MetropoliaMotorsport/AMS-MASTER/README.md

Changes for next year:
Labels on other side
Remove unused connectors
Add connection for temperature measurement of DCDC
