MetropoliaMotorsport/AMS-MASTER/AMS Master BOM.xlsx

References | Value | Footprint | Quantity | €/pc | Total price
C5, C19, C20, C21, C23, C24, C25, C26, C27, C28, C29, C30, C31, C32, C33, C34, C35, C37, C39, C40, C41, C42 | 100nF | C_0805_2012Metric_Pad1.18x1.45mm_HandSolder | 22 | 0.04 € | 0.88 €
C1, C2, C36 | 30pF | C_0805_2012Metric_Pad1.18x1.45mm_HandSolder | 3 | 0.31 € | 0.93 €
C3, C4 | 100nF | C_0603_1608Metric_Pad1.08x0.95mm_HandSolder | 2 | 0.04 € | 0.08 €
C9, C13 | 2.2uF | C_0805_2012Metric_Pad1.18x1.45mm_HandSolder | 2 | 0.19 € | 0.38 €
C10, C14 | 0.22uF | C_0805_2012Metric_Pad1.18x1.45mm_HandSolder | 2 | 0.10 € | 0.20 €
C11, C15 | 22pF | C_0805_2012Metric_Pad1.18x1.45mm_HandSolder | 2 | 0.15 € | 0.30 €
C12, C16 | 22uF | C_0805_2012Metric_Pad1.18x1.45mm_HandSolder | 2 | 0.22 € | 0.44 €
C6 | 4.7uF | C_0603_1608Metric_Pad1.08x0.95mm_HandSolder | 1 | 0.15 € | 0.15 €
C7 | 10nF | C_0603_1608Metric_Pad1.08x0.95mm_HandSolder | 1 | 0.23 € | 0.23 €
C8 | 1uF | C_0603_1608Metric_Pad1.08x0.95mm_HandSolder | 1 | 0.15 € | 0.15 €
C17 | 10nF | C_0805_2012Metric_Pad1.18x1.45mm_HandSolder | 1 | 0.46 € | 0.46 €
C18 | 10uF | C_0805_2012Metric_Pad1.18x1.45mm_HandSolder | 1 | 0.31 € | 0.31 €
C38 | 4.7nF | C_0805_2012Metric_Pad1.18x1.45mm_HandSolder | 1 | 0.90 € | 0.90 €
R2, R13, R14, R15, R40, R41, R42, R43 | 10k | R_0805_2012Metric_Pad1.20x1.40mm_HandSolder | 8 | 0.02 € | 0.16 €
R16, R17, R18, R19, R20, R21 | 33k | R_0805_2012Metric_Pad1.20x1.40mm_HandSolder | 6 | 0.01 € | 0.06 €
R23, R31, R45, R47 | 11k | R_0805_2012Metric_Pad1.20x1.40mm_HandSolder | 4 | 0.03 € | 0.12 €
R4, R12, R44 | 470 | R_0805_2012Metric_Pad1.20x1.40mm_HandSolder | 3 | 0.03 € | 0.09 €
R8, R38, R39 | 330 | R_0805_2012Metric_Pad1.20x1.40mm_HandSolder | 3 | 0.03 € | 0.09 €
R22, R24, R46 | 6k | R_0805_2012Metric_Pad1.20x1.40mm_HandSolder | 3 | 0.02 € | 0.06 €
R25, R26, R28 | 22k | R_0805_2012Metric_Pad1.20x1.40mm_HandSolder | 3 | 0.03 € | 0.09 €
R1, R3 | 331 | R_0603_1608Metric_Pad0.98x0.95mm_HandSolder | 2 | 0.11 € | 0.22 €
R6, R10 | 1M | R_0805_2012Metric_Pad1.20x1.40mm_HandSolder | 2 | 0.03 € | 0.06 €
R34, R35 | 1k | R_0805_2012Metric_Pad1.20x1.40mm_HandSolder | 2 | 0.28 € | 0.56 €
R36, R37 | 60 | R_0603_1608Metric_Pad0.98x0.95mm_HandSolder | 2 | 0.26 € | 0.52 €
R5 | 220k | R_0805_2012Metric_Pad1.20x1.40mm_HandSolder | 1 | 0.03 € | 0.03 €
R7 | 576k | R_0805_2012Metric_Pad1.20x1.40mm_HandSolder | 1 | 0.03 € | 0.03 €
R9 | 226k | R_0805_2012Metric_Pad1.20x1.40mm_HandSolder | 1 | 0.03 € | 0.03 €
R11 | 316k | R_0805_2012Metric_Pad1.20x1.40mm_HandSolder | 1 | 0.03 € | 0.03 €
R27 | 2.2k | R_0805_2012Metric_Pad1.20x1.40mm_HandSolder | 1 | 0.28 € | 0.28 €
R29 | 15k | R_0805_2012Metric_Pad1.20x1.40mm_HandSolder | 1 | 0.03 € | 0.03 €
R30 | 9.1k | R_0805_2012Metric_Pad1.20x1.40mm_HandSolder | 1 | 0.34 € | 0.34 €
R32 | 13k | R_0805_2012Metric_Pad1.20x1.40mm_HandSolder | 1 | 0.03 € | 0.03 €
R33 | 1.21k | R_0805_2012Metric_Pad1.20x1.40mm_HandSolder | 1 | 0.28 € | 0.28 €
L1, L2 | 22uH | SLF7045T | 2 | 1.04 € | 2.08 €
D1, D2, D3, D4, D11 | KT-0603R | LED_0603_1608Metric_Pad1.05x0.95mm_HandSolder | 5 | 0.13 € | 0.65 €
D7, D8, D9, D12 | 5.1V | SOD-323 | 4 | 0.08 € | 0.32 €
D5 | STPS5L25B-TR | TO-252-2_TabPin1 | 1 | 1.63 € | 1.63 €
D6 | SMBJ26A | DO-214AA | 1 | 0.43 € | 0.43 €
U6, U7, U8, U9, U10 | LM293 | SOIC-8 | 5 | 0.33 € | 1.65 €
U2, U3 | LT3970 | LT3970 | 2 | 5.72 € | 11.44 €
U4, U5 | OR-gate | SOT-753 | 2 | 0.19 € | 0.38 €
U1 | STM32G431KBTx | LQFP-32_7x7mm_P0.8mm | 1 | 7.22 € | 7.22 €
U11 | LTC6820 | ltc6820 | 1 | 6.54 € | 6.54 €
U12 | SN65HVD230 | SOIC-8_3.9x4.9mm_P1.27mm | 1 | 3.28 € | 3.28 €
U13 | ESDCAN24-2BLY | SOT-23-3 | 1 | 0.42 € | 0.42 €
Y1 | 16MHz Crystal | Crystal_SMD_HC49-SD | 1 | 0.33 € | 0.33 €
F1 | DLW5BTM501TQ2L | Filter_DLW5BTM501TQ2L | 1 | 1.16 € | 1.16 €
SW1 | CS11024.3F160 | SW_Push_1P1T_NO_6x6mm_H9.5mm | 1 | 0.25 € | 0.25 €
Q1, Q2 | AO4612 | SOIC-8_3.9x4.9mm_P1.27mm | 2 | 0.73 € | 1.46 €
Q3, Q4 | BSS123 | SOT-323_SC-70_Handsoldering | 2 | 0.27 € | 0.54 €
T1-1 | SM91501AL-E | SM91501AL-E | 1 | 5.08 € | 5.08 €
J2, J3, J4, J5, J7, J8 | Molex 26-01-3127 | Molex_Mini-Fit_Jr_5569-02A2_2x01_P4.20mm_Horizontal | 6 | 0.68 € | 4.08 €
J6, J9 | Molex 39303036 | Molex_Mini-Fit_Jr_5569-03A4_1x03_P4.20mm_Horizontal | 2 | 0.74 € | 1.48 €
J1 | Molex 39301040 | Molex_Mini-Fit_Jr_5569-04A2_2x02_P4.20mm_Horizontal | 1 | 0.58 € | 0.58 €
PCB |  |  | 1 | 27.11 € | 27.11 €
 |  |  |  |  | 86.63 €
