MetropoliaMotorsport/AMS-MASTER/AMS Master V8.kicad_pcb

## KiCad design AMS Master V8.kicad_pcb (2024-07-11)

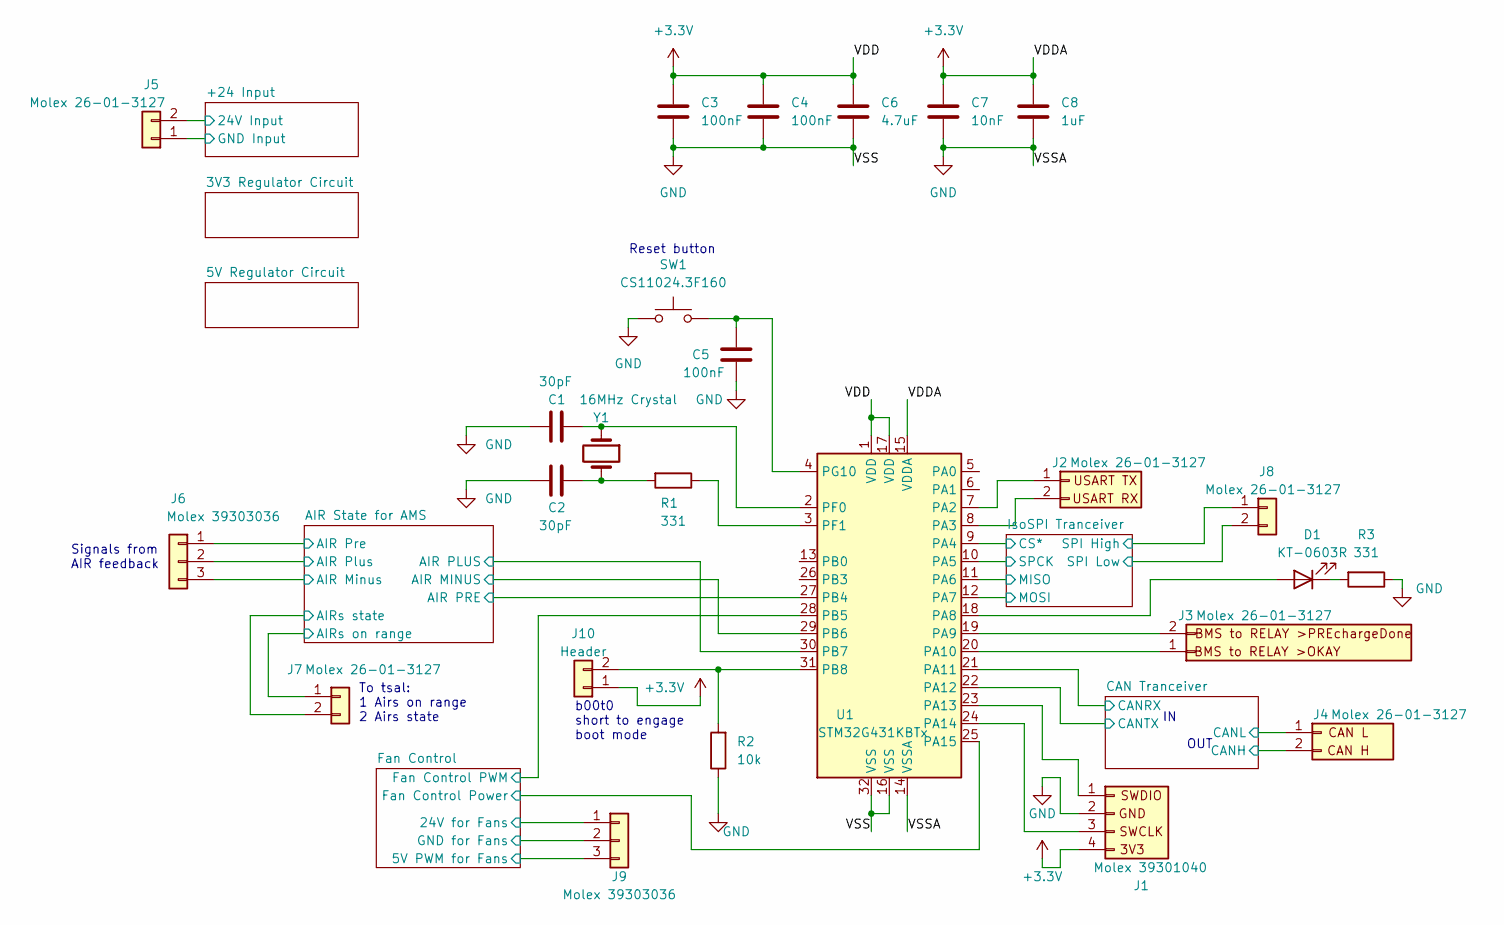
[picture p1: schematic AMS Master V8.kicad_sch, AMS Master by Jakub Sułek]

Parts:
C1, C2: 30pF; C_0805_2012Metric_Pad1.18x1.45mm_HandSolder
C3, C4: 100nF; C_0603_1608Metric_Pad1.08x0.95mm_HandSolder
C5: 100nF; C_0805_2012Metric_Pad1.18x1.45mm_HandSolder
C6: 4.7uF; C_0603_1608Metric_Pad1.08x0.95mm_HandSolder
C7: 10nF; C_0603_1608Metric_Pad1.08x0.95mm_HandSolder
C8: 1uF; C_0603_1608Metric_Pad1.08x0.95mm_HandSolder
D1: KT-0603R; LED_0603_1608Metric_Pad1.05x0.95mm_HandSolder
J1: Molex 39301040; Molex_Mini-Fit_Jr_5569-04A2_2x02_P4.20mm_Horizontal
J2, J3, J4, J5, J7, J8: Molex 26-01-3127; Molex_Mini-Fit_Jr_5569-02A2_2x01_P4.20mm_Horizontal
J6, J9: Molex 39303036; Molex_Mini-Fit_Jr_5569-03A4_1x03_P4.20mm_Horizontal
J10: Header; PinHeader_1x02_P2.54mm_Vertical
R1, R3: 331; R_0603_1608Metric_Pad0.98x0.95mm_HandSolder
R2: 10k; R_0805_2012Metric_Pad1.20x1.40mm_HandSolder
SW1: CS11024.3F160; SW_Push_1P1T_NO_6x6mm_H9.5mm
U1: STM32G431KBTx; LQFP-32_7x7mm_P0.8mm
Y1: 16MHz Crystal; Crystal_SMD_HC49-SD

Connections:
+VDC: J5.2; also elsewhere on the board
/AIR State for AMS/AIR MINUS: U1.29 (PB6); also elsewhere on the board
/AIR State for AMS/AIR Minus: J6.3; also elsewhere on the board
/AIR State for AMS/AIR PLUS: U1.30 (PB7); also elsewhere on the board
/AIR State for AMS/AIR PRE: U1.27 (PB4); also elsewhere on the board
/AIR State for AMS/AIR Plus: J6.2; also elsewhere on the board
/AIR State for AMS/AIR Pre: J6.1; also elsewhere on the board
/AIR State for AMS/AIRs on range: J7.1; also elsewhere on the board
/AIR State for AMS/AIRs state: J7.2; also elsewhere on the board
/CAN Tranceiver/CANH: J4.2; also elsewhere on the board
/CAN Tranceiver/CANL: J4.1; also elsewhere on the board
/CAN Tranceiver/CANRX: U1.21 (PA11); also elsewhere on the board
/CAN Tranceiver/CANTX: U1.22 (PA12); also elsewhere on the board
/Fan Control/5V PWM for Fans: J9.3, U1.28 (PB5)
/Fan Control/24V for Fans: J9.1; also elsewhere on the board
/Fan Control/Fan Control Power: U1.25 (PA15); also elsewhere on the board
/IsoSPI Tranceiver/CS*: U1.9 (PA4); also elsewhere on the board
/IsoSPI Tranceiver/MISO: U1.11 (PA6); also elsewhere on the board
/IsoSPI Tranceiver/MOSI: U1.12 (PA7); also elsewhere on the board
/IsoSPI Tranceiver/SPCK: U1.10 (PA5); also elsewhere on the board
/IsoSPI Tranceiver/SPI High: J8.1; also elsewhere on the board
/IsoSPI Tranceiver/SPI Low: J8.2; also elsewhere on the board
unnamed: C2.1, R1.2, Y1.2
unnamed: D1.2 (A), U1.18 (PA8)
unnamed: D1.1 (K), R3.2
unnamed: J1.1, U1.23 (PA13)
unnamed: J1.3, U1.24 (PA14)
unnamed: J2.1, U1.7 (PA2)
unnamed: J2.2, U1.8 (PA3)
unnamed: J3.1, U1.20 (PA10)
unnamed: J3.2, U1.19 (PA9)
unnamed: J10.2, R2.2, U1.31 (PB8)
unnamed: C1.1, U1.2 (PF0), Y1.1
unnamed: R1.1, U1.3 (PF1)
unnamed: C5.1, SW1.2, U1.4 (PG10)

Notes on the sheet:
OUT
Reset button
To tsal: 1 Airs on range 2 Airs state
b00t0 short to engage boot mode
Signals from AIR feedback

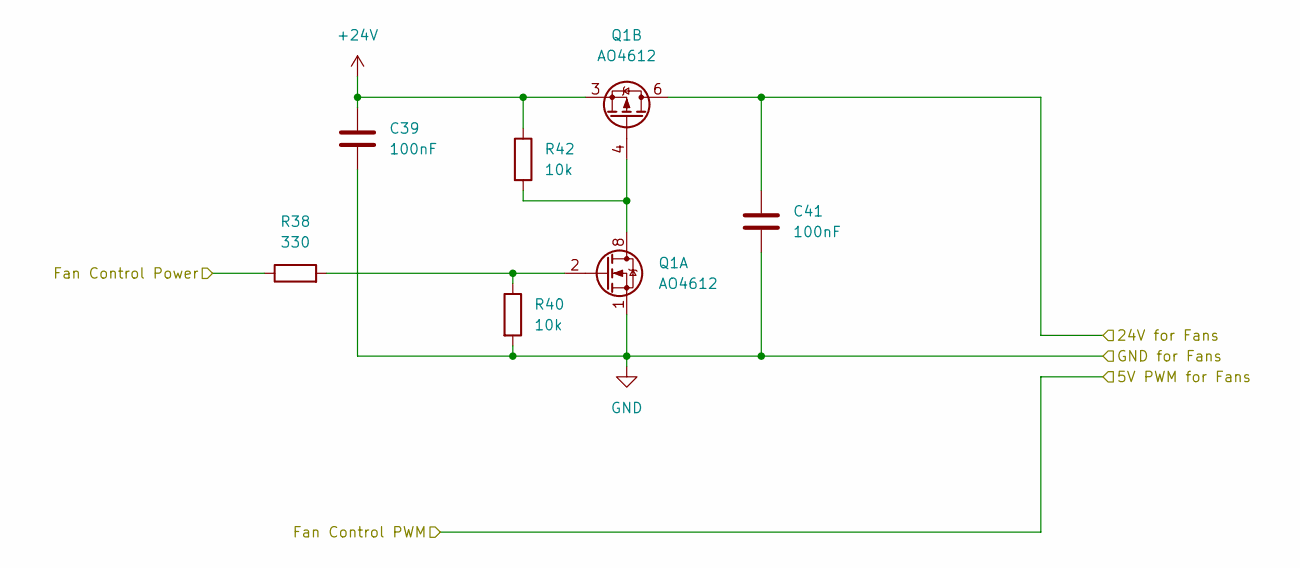
[picture p2: schematic Fan Control.kicad_sch, AMS Master by Jakub Sułek]

Parts:
C39, C41: 100nF; C_0805_2012Metric_Pad1.18x1.45mm_HandSolder
Q1: AO4612; SOIC-8_3.9x4.9mm_P1.27mm
R38: 330; R_0805_2012Metric_Pad1.20x1.40mm_HandSolder
R40, R42: 10k; R_0805_2012Metric_Pad1.20x1.40mm_HandSolder

Connections:
+24V: C39.1, Q1.3 (1), R42.1; also elsewhere on the board
/Fan Control/24V for Fans: C41.1, Q1.5 (D), Q1.6 (D); also elsewhere on the board
/Fan Control/Fan Control Power: R38.1; also elsewhere on the board
unnamed: Q1.2 (G), R38.2, R40.1
unnamed: Q1.4 (G), Q1.7 (D), Q1.8 (D), R42.2

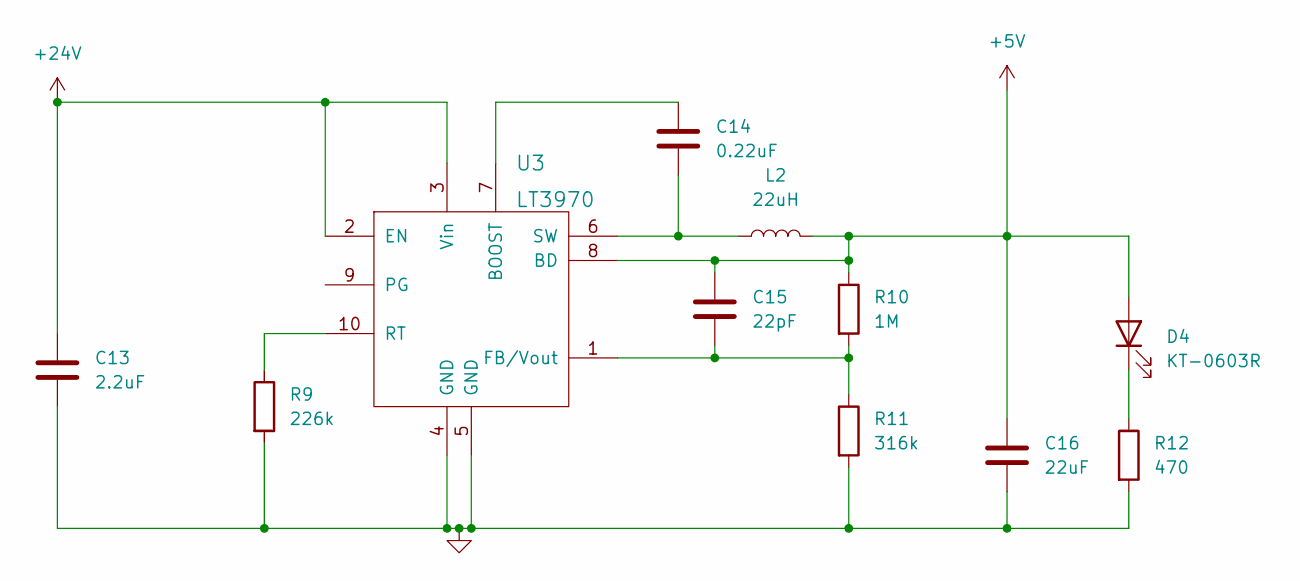
[picture p3: schematic 5V Regulator Circuit.kicad_sch, AMS Master by Jakub Sułek]

Parts:
C13: 2.2uF; C_0805_2012Metric_Pad1.18x1.45mm_HandSolder
C14: 0.22uF; C_0805_2012Metric_Pad1.18x1.45mm_HandSolder
C15: 22pF; C_0805_2012Metric_Pad1.18x1.45mm_HandSolder
C16: 22uF; C_0805_2012Metric_Pad1.18x1.45mm_HandSolder
D4: KT-0603R; LED_0603_1608Metric_Pad1.05x0.95mm_HandSolder
L2: 22uH; SLF7045T
R9: 226k; R_0805_2012Metric_Pad1.20x1.40mm_HandSolder
R10: 1M; R_0805_2012Metric_Pad1.20x1.40mm_HandSolder
R11: 316k; R_0805_2012Metric_Pad1.20x1.40mm_HandSolder
R12: 470; R_0805_2012Metric_Pad1.20x1.40mm_HandSolder
U3: LT3970

Connections:
+5V: C15.1, C16.1, D4.2 (A), L2.2, R10.1, U3.8 (BD); also elsewhere on the board
+24V: C13.1, U3.2 (EN), U3.3 (Vin); also elsewhere on the board
unnamed: D4.1 (K), R12.1
unnamed: C14.1, U3.7 (BOOST)
unnamed: C15.2, R10.2, R11.1, U3.1 (FB/Vout)
unnamed: R9.1, U3.10 (RT)
unnamed: C14.2, L2.1, U3.6 (SW)

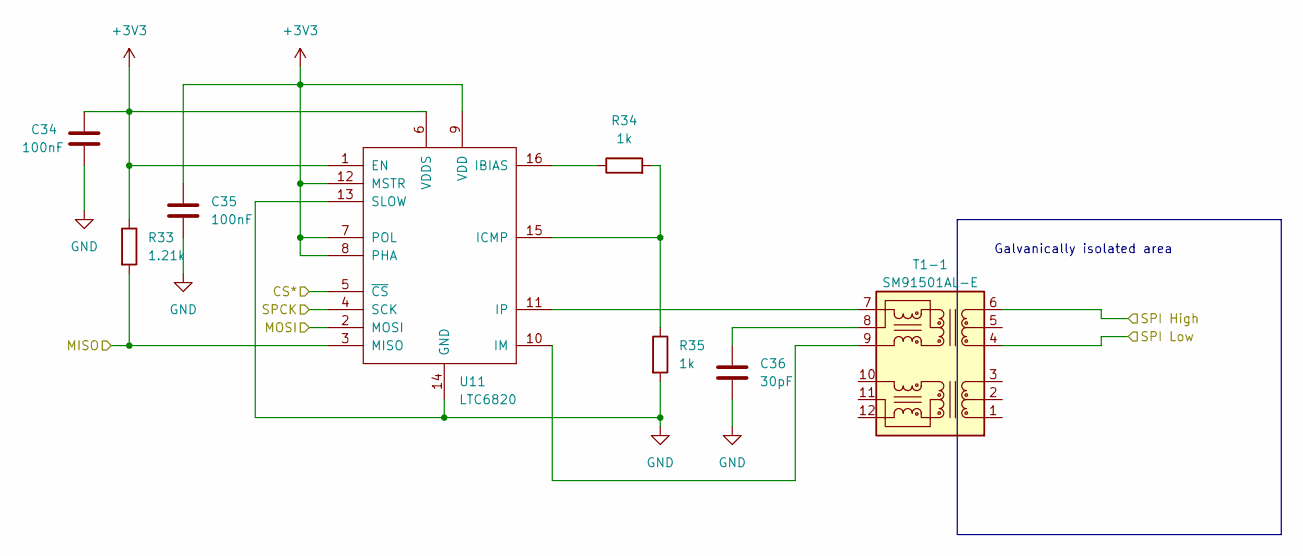
[picture p4: schematic IsoSPI Tranceiver.kicad_sch, AMS Master by Jakub Sułek]

Parts:
C34, C35: 100nF; C_0805_2012Metric_Pad1.18x1.45mm_HandSolder
C36: 30pF; C_0805_2012Metric_Pad1.18x1.45mm_HandSolder
R33: 1.21k; R_0805_2012Metric_Pad1.20x1.40mm_HandSolder
R34, R35: 1k; R_0805_2012Metric_Pad1.20x1.40mm_HandSolder
T1-1: SM91501AL-E
U11: LTC6820; ltc6820

Connections:
/IsoSPI Tranceiver/CS*: U11.5 (~CS); also elsewhere on the board
/IsoSPI Tranceiver/MISO: R33.2, U11.3 (MISO); also elsewhere on the board
/IsoSPI Tranceiver/MOSI: U11.2 (MOSI); also elsewhere on the board
/IsoSPI Tranceiver/SPCK: U11.4 (SCK); also elsewhere on the board
/IsoSPI Tranceiver/SPI High: T1-1.6; also elsewhere on the board
/IsoSPI Tranceiver/SPI Low: T1-1.4; also elsewhere on the board
unnamed: C36.1, T1-1.8
unnamed: R34.1, U11.16 (IBIAS)
unnamed: R34.2, R35.1, U11.15 (ICMP)
unnamed: T1-1.9, U11.10 (IM)
unnamed: T1-1.7, U11.11 (IP)

Notes on the sheet:
Galvanically isolated area

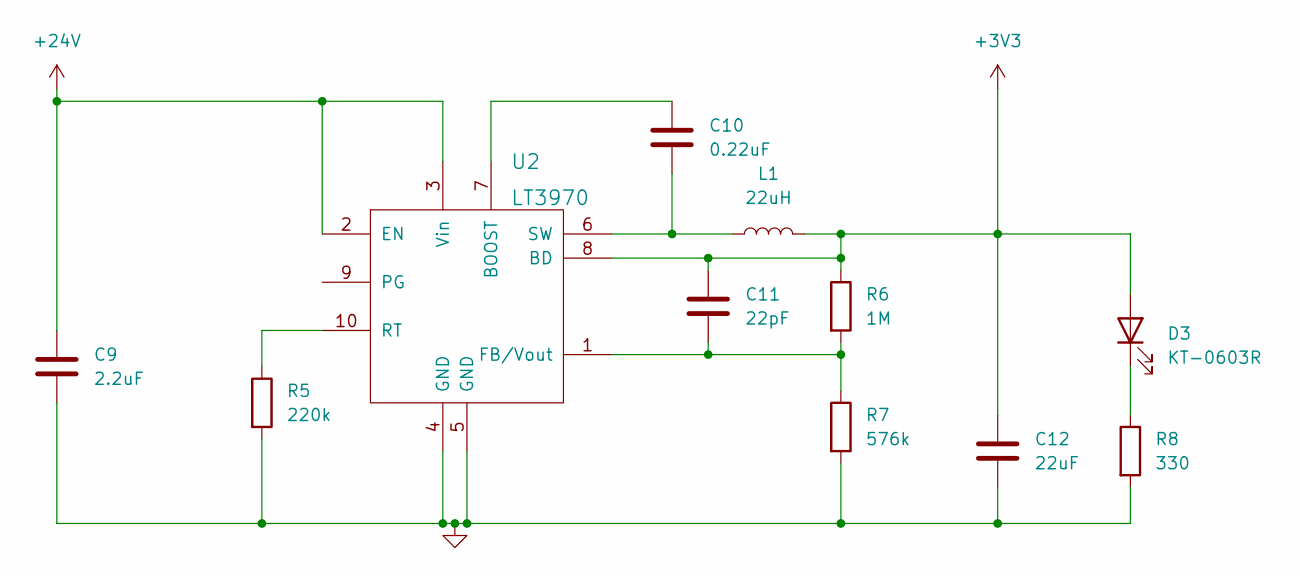
[picture p5: schematic 3V3 Regulator Circuit.kicad_sch, AMS Master by Jakub Sułek]

Parts:
C9: 2.2uF; C_0805_2012Metric_Pad1.18x1.45mm_HandSolder
C10: 0.22uF; C_0805_2012Metric_Pad1.18x1.45mm_HandSolder
C11: 22pF; C_0805_2012Metric_Pad1.18x1.45mm_HandSolder
C12: 22uF; C_0805_2012Metric_Pad1.18x1.45mm_HandSolder
D3: KT-0603R; LED_0603_1608Metric_Pad1.05x0.95mm_HandSolder
L1: 22uH; SLF7045T
R5: 220k; R_0805_2012Metric_Pad1.20x1.40mm_HandSolder
R6: 1M; R_0805_2012Metric_Pad1.20x1.40mm_HandSolder
R7: 576k; R_0805_2012Metric_Pad1.20x1.40mm_HandSolder
R8: 330; R_0805_2012Metric_Pad1.20x1.40mm_HandSolder
U2: LT3970

Connections:
+24V: C9.1, U2.2 (EN), U2.3 (Vin); also elsewhere on the board
unnamed: D3.1 (K), R8.1
unnamed: C10.1, U2.7 (BOOST)
unnamed: C11.2, R6.2, R7.1, U2.1 (FB/Vout)
unnamed: R5.1, U2.10 (RT)
unnamed: C10.2, L1.1, U2.6 (SW)

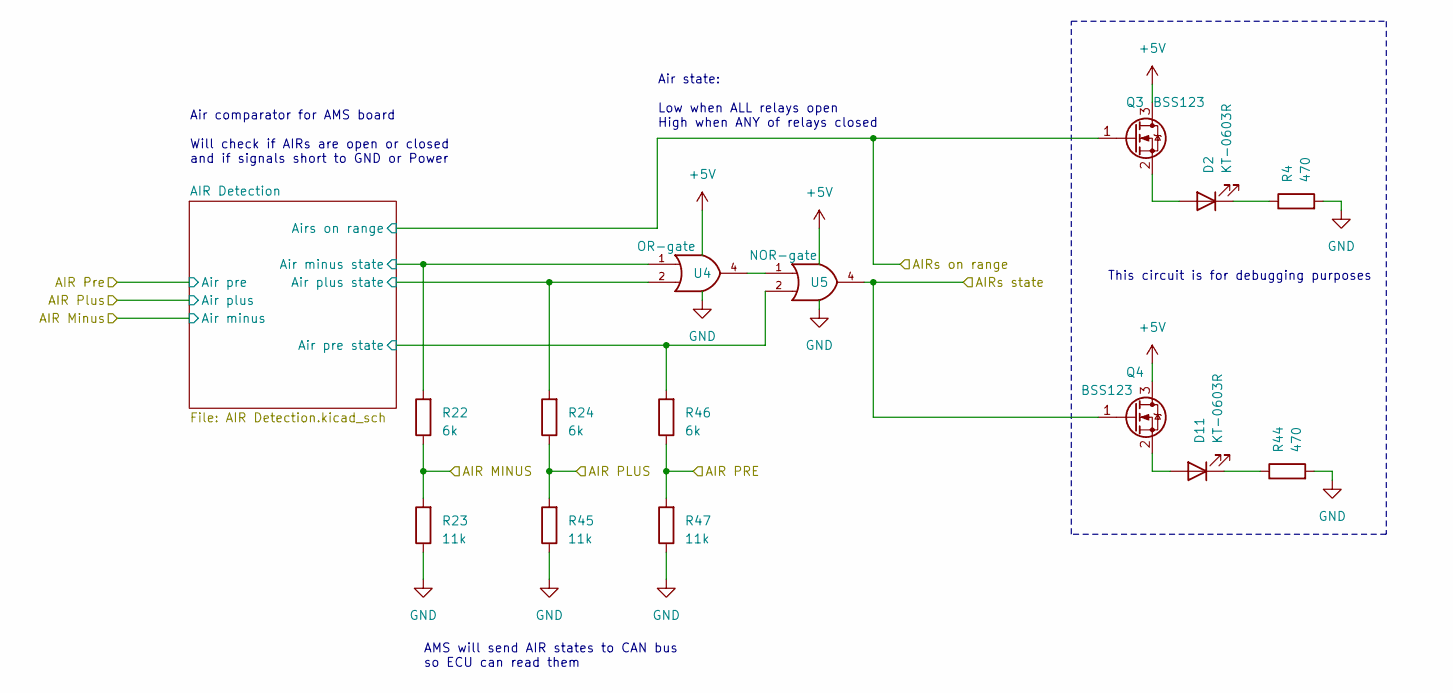
[picture p6: schematic AIR State for AMS.kicad_sch, AMS Master by Jakub Sułek]

Parts:
D2, D11: KT-0603R; LED_0603_1608Metric_Pad1.05x0.95mm_HandSolder
Q3, Q4: BSS123; SOT-323_SC-70_Handsoldering
R4, R44: 470; R_0805_2012Metric_Pad1.20x1.40mm_HandSolder
R22, R24, R46: 6k; R_0805_2012Metric_Pad1.20x1.40mm_HandSolder
R23, R45, R47: 11k; R_0805_2012Metric_Pad1.20x1.40mm_HandSolder
U4: OR-gate; SOT-753
U5: NOR-gate; SOT-753

Connections:
+5V: Q3.3 (D), Q4.3 (D), U4.5 (VCC), U5.5 (VCC); also elsewhere on the board
/AIR State for AMS/AIR Detection/Air minus state: R22.2, U4.1; also elsewhere on the board
/AIR State for AMS/AIR Detection/Air plus state: R24.2, U4.2; also elsewhere on the board
/AIR State for AMS/AIR Detection/Air pre state: R46.2, U5.2; also elsewhere on the board
/AIR State for AMS/AIR MINUS: R22.1, R23.2; also elsewhere on the board
/AIR State for AMS/AIR PLUS: R24.1, R45.2; also elsewhere on the board
/AIR State for AMS/AIR PRE: R46.1, R47.2; also elsewhere on the board
/AIR State for AMS/AIRs on range: Q3.1 (G); also elsewhere on the board
/AIR State for AMS/AIRs state: Q4.1 (G), U5.4; also elsewhere on the board
unnamed: D2.2 (A), Q3.2 (S)
unnamed: D2.1 (K), R4.1
unnamed: D11.2 (A), Q4.2 (S)
unnamed: D11.1 (K), R44.1
unnamed: U4.4, U5.1

Notes on the sheet:
This circuit is for debugging purposes
Air state: Low when ALL relays open High when ANY of relays closed
AMS will send AIR states to CAN bus so ECU can read them
Air comparator for AMS board Will check if AIRs are open or closed and if signals short to GND or Power

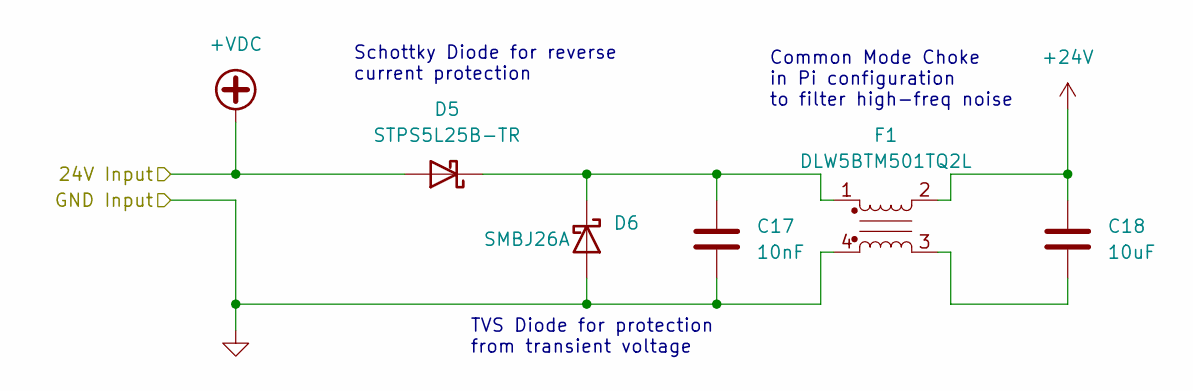
[picture p7: schematic +24 Input.kicad_sch, AMS Master by Jakub Sułek]

Parts:
C17: 10nF; C_0805_2012Metric_Pad1.18x1.45mm_HandSolder
C18: 10uF; C_0805_2012Metric_Pad1.18x1.45mm_HandSolder
D5: STPS5L25B-TR; TO-252-2_TabPin1
D6: SMBJ26A; D_SMB
F1: DLW5BTM501TQ2L

Connections:
+24V: C18.1, F1.2; also elsewhere on the board
+VDC: D5.2 (A); also elsewhere on the board
unnamed: C18.2, F1.3
unnamed: C17.1, D5.1 (K), D6.1 (K), F1.1

Notes on the sheet:
Common Mode Choke in Pi configuration to filter high-freq noise
Schottky Diode for reverse current protection
TVS Diode for protection from transient voltage

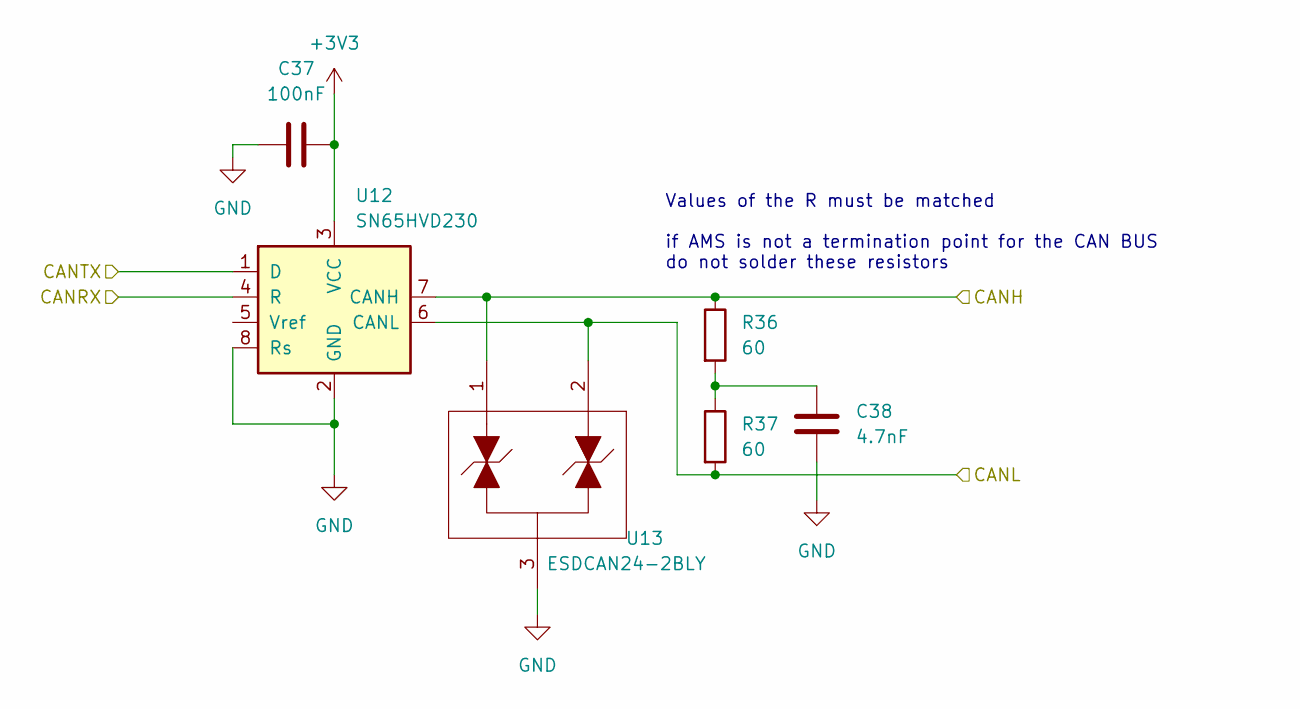
[picture p8: schematic CAN Tranceiver.kicad_sch, AMS Master by Jakub Sułek]

Parts:
C37: 100nF; C_0805_2012Metric_Pad1.18x1.45mm_HandSolder
C38: 4.7nF; C_0805_2012Metric_Pad1.18x1.45mm_HandSolder
R36, R37: 60; R_0603_1608Metric_Pad0.98x0.95mm_HandSolder
U12: SN65HVD230; SOIC-8_3.9x4.9mm_P1.27mm
U13: ESDCAN24-2BLY; SOT-23-3

Connections:
/CAN Tranceiver/CANH: R36.1, U12.7 (CANH), U13.1; also elsewhere on the board
/CAN Tranceiver/CANL: R37.2, U12.6 (CANL), U13.2; also elsewhere on the board
/CAN Tranceiver/CANRX: U12.4 (R); also elsewhere on the board
/CAN Tranceiver/CANTX: U12.1 (D); also elsewhere on the board
unnamed: C38.1, R36.2, R37.1

Notes on the sheet:
Values of the R must be matched if AMS is not a termination point for the CAN BUS do not solder these resistors

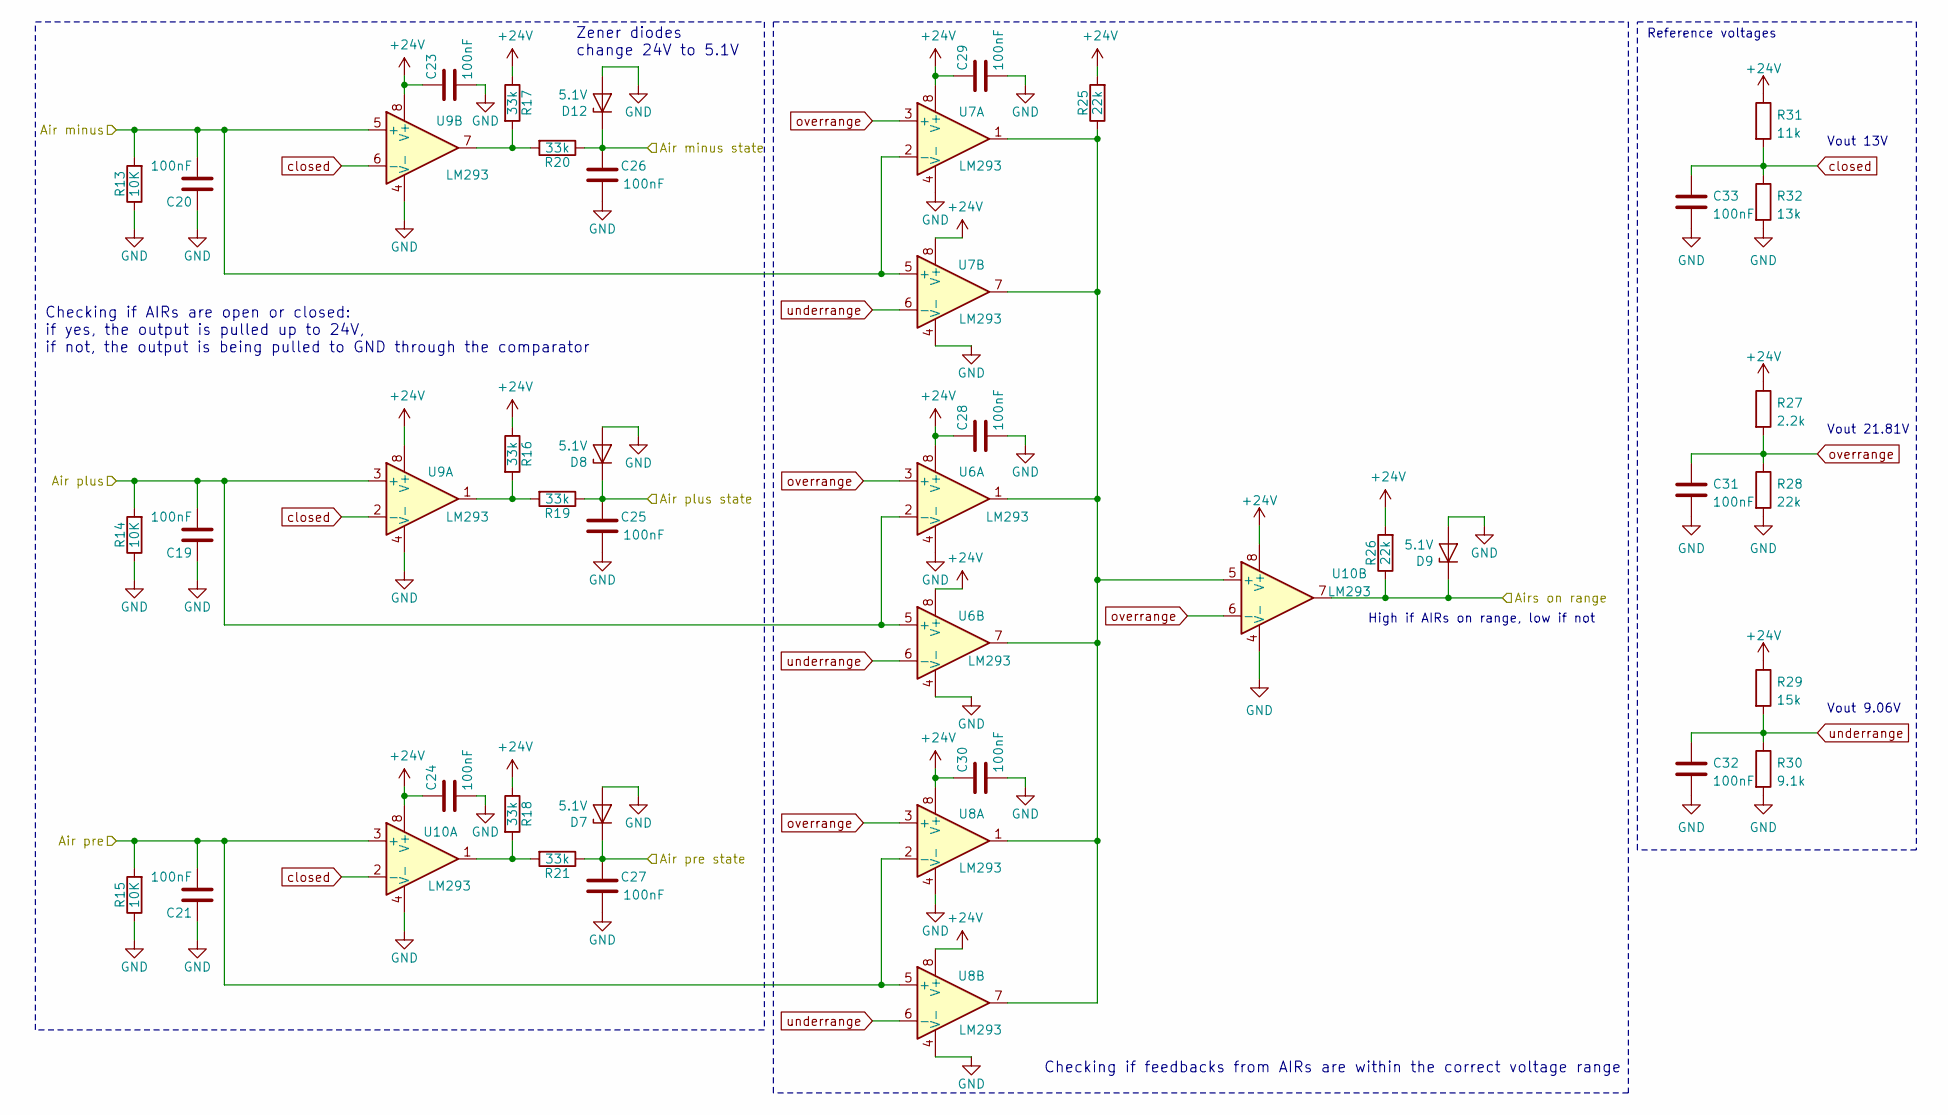
[picture p9: schematic AIR Detection.kicad_sch, AMS Master by Jakub Sułek]

Parts:
C19, C20, C21, C23, C24, C25, C26, C27, C28, C29, C30, C31, C32, C33: 100nF; C_0805_2012Metric_Pad1.18x1.45mm_HandSolder
D7, D8, D9, D12: 5.1V; SOD-323
R13, R14, R15: 10K; R_0805_2012Metric_Pad1.20x1.40mm_HandSolder
R16, R17, R18, R19, R20, R21: 33k; R_0805_2012Metric_Pad1.20x1.40mm_HandSolder
R25, R26, R28: 22k; R_0805_2012Metric_Pad1.20x1.40mm_HandSolder
R27: 2.2k; R_0805_2012Metric_Pad1.20x1.40mm_HandSolder
R29: 15k; R_0805_2012Metric_Pad1.20x1.40mm_HandSolder
R30: 9.1k; R_0805_2012Metric_Pad1.20x1.40mm_HandSolder
R31: 11k; R_0805_2012Metric_Pad1.20x1.40mm_HandSolder
R32: 13k; R_0805_2012Metric_Pad1.20x1.40mm_HandSolder
U6, U7, U8, U9, U10: LM293; SOIC-8

Connections:
+24V: C23.1, C24.1, C28.1, C29.1, C30.1, R16.1, R17.1, R18.1, R25.2, R26.2, R27.1, R29.1, R31.1, U6.8 (V+), U7.8 (V+), U8.8 (V+), U9.8 (V+), U10.8 (V+); also elsewhere on the board
/AIR State for AMS/AIR Detection/Air minus state: C26.2, D12.1 (K), R20.1; also elsewhere on the board
/AIR State for AMS/AIR Detection/Air plus state: C25.2, D8.1 (K), R19.1; also elsewhere on the board
/AIR State for AMS/AIR Detection/Air pre state: C27.2, D7.1 (K), R21.1; also elsewhere on the board
/AIR State for AMS/AIR Minus: C20.2, R13.2, U7.2 (-), U7.5 (+), U9.5 (+); also elsewhere on the board
/AIR State for AMS/AIR Plus: C19.2, R14.2, U6.2 (-), U6.5 (+), U9.3 (+); also elsewhere on the board
/AIR State for AMS/AIR Pre: C21.2, R15.2, U8.2 (-), U8.5 (+), U10.3 (+); also elsewhere on the board
/AIR State for AMS/AIRs on range: D9.1 (K), R26.1, U10.7; also elsewhere on the board
unnamed: R16.2, R19.2, U9.1
unnamed: R17.2, R20.2, U9.7
unnamed: R18.2, R21.2, U10.1
unnamed: R25.1, U6.1, U6.7, U7.1, U7.7, U8.1, U8.7, U10.5 (+)
closed: C33.1, R31.2, R32.1, U9.2 (-), U9.6 (-), U10.2 (-)
overrange: C31.1, R27.2, R28.1, U6.3 (+), U7.3 (+), U8.3 (+), U10.6 (-)
underrange: C32.1, R29.2, R30.1, U6.6 (-), U7.6 (-), U8.6 (-)

Notes on the sheet:
Vout 13V
Vout 21.81V
Zener diodes change 24V to 5.1V
Checking if AIRs are open or closed: if yes, the output is pulled up to 24V, if not, the output is being pulled to GND through the comparator
Reference voltages
Vout 9.06V
High if AIRs on range, low if not
Checking if feedbacks from AIRs are within the correct voltage range

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
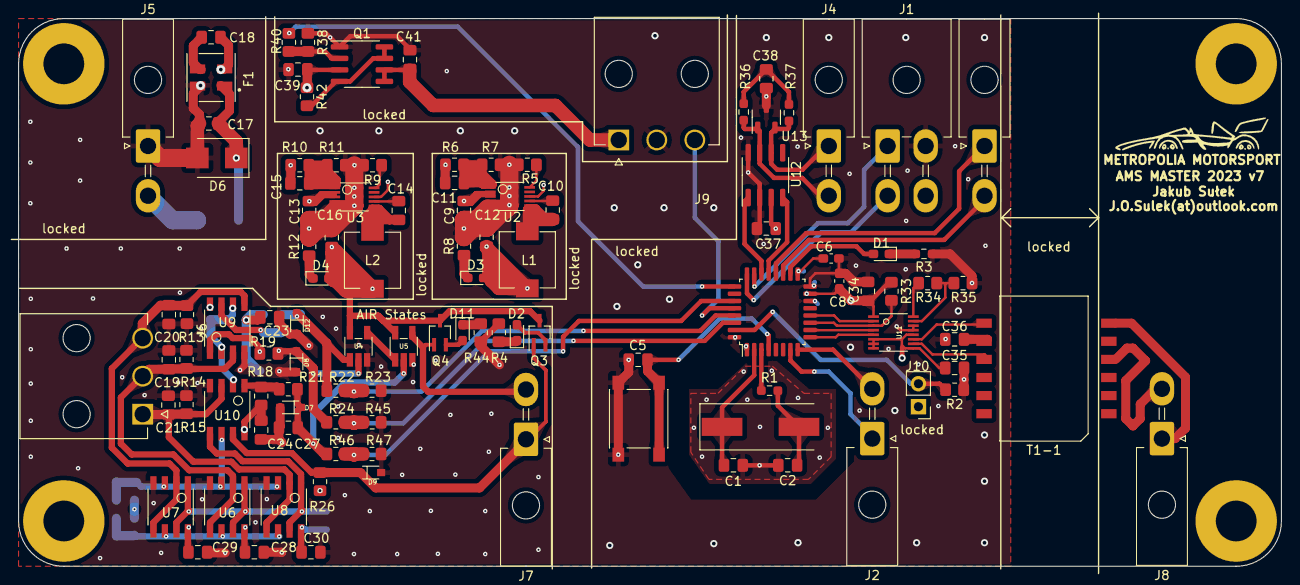
[picture p10: board AMS Master V8.kicad_pcb from above]

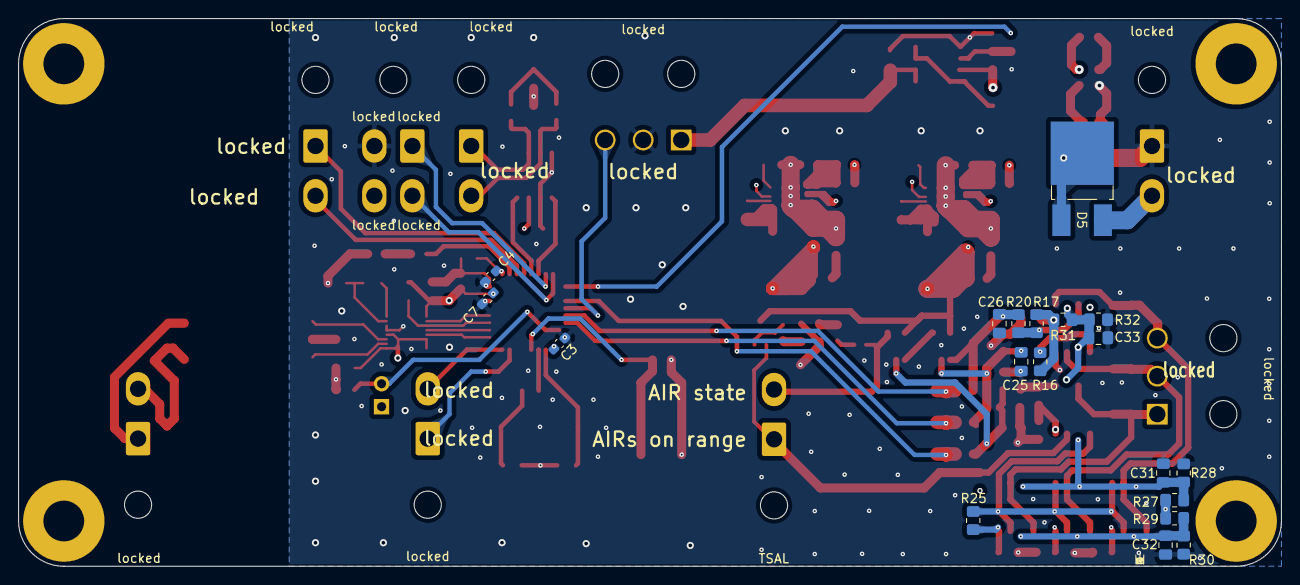
[picture p11: board AMS Master V8.kicad_pcb from below]

Board: 4 copper layers, 139.5 x 60.5 mm, 126 parts (19 on the bottom side), 74 nets.
